pinchy/PrototypeFanControlPCB/SEM002.2003 - FanControl.brd

## EAGLE design SEM002.2003 - FanControl.brd (2020-03-23)

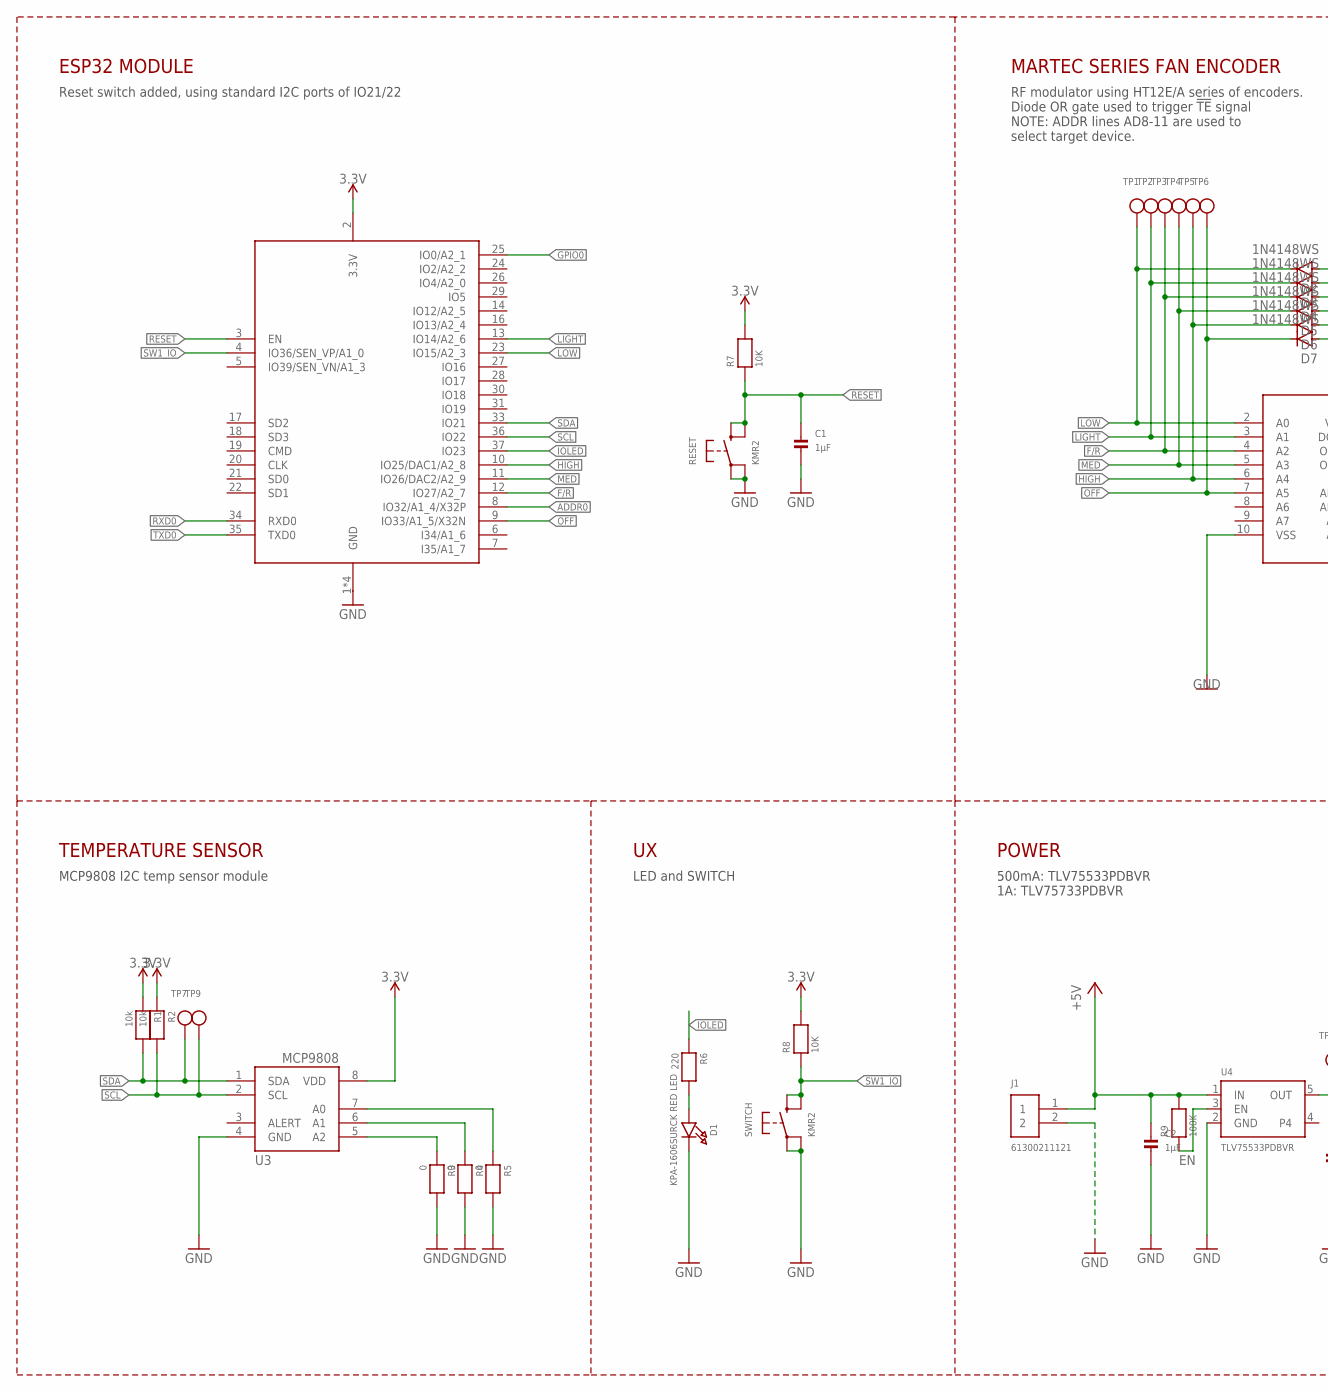
[picture p1: schematic SEM002.2003 - FanControl.sch, part in row 1, column 1]

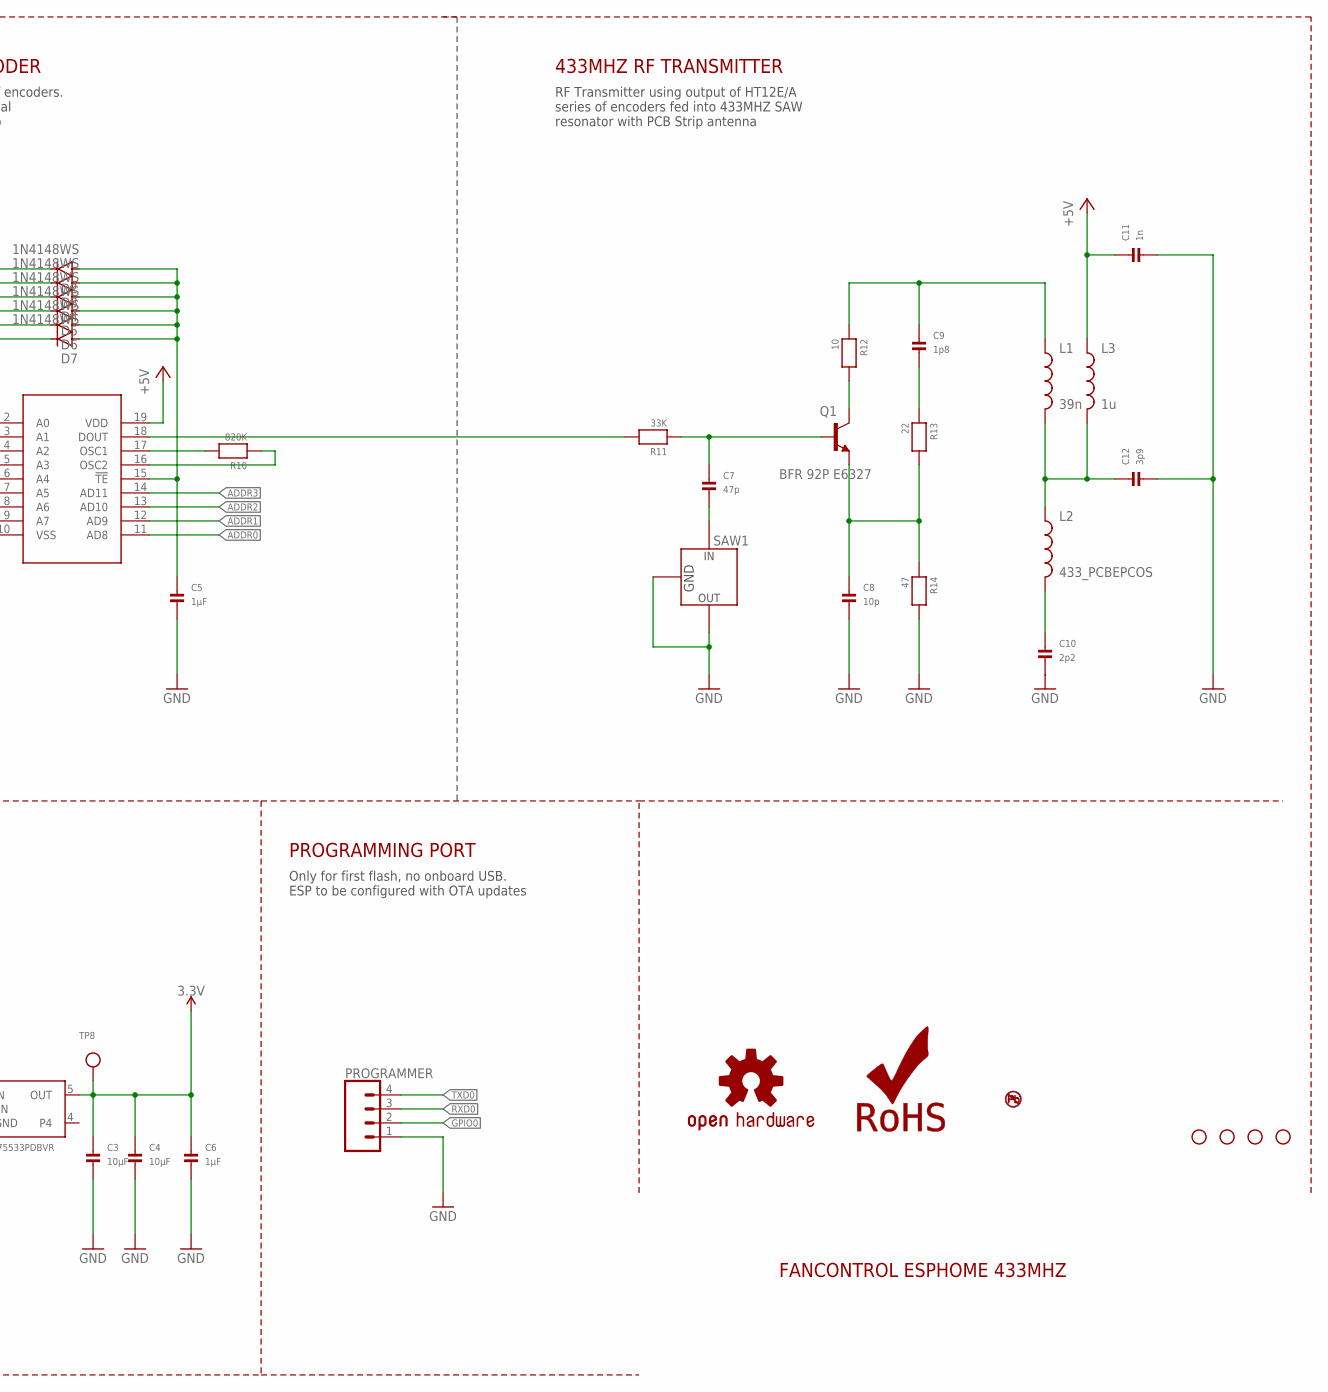
[picture p2: schematic SEM002.2003 - FanControl.sch, part in row 1, column 2]

Parts:
C1, C6: 1µF; 0603; MPN LMK107B7105KA-T
C2: 1µF; 0805_NOTHERMALS; MPN LMK107B7105KA-T
C3: 10µF; 0603; MPN 0805YD106MAT4A
C4: 10µF; 0805_NOTHERMALS; MPN 0805YD106MAT4A
C5: 1µF; 0603-MINI; MPN LMK107B7105KA-T
C7: 47p; 0603-MINI; MPN 0603N470F500CT
C8: 10p; 0603-MINI; MPN 0603N100F500CT
C9: 1p8; 0603-MINI; MPN 0603N1R8B101CT
C10: 2p2; 0603-MINI; MPN 0603N2R2B101CT
C11: 1n; 0603-MINI; MPN 0603N102F500CT
C12: 3p9; 0603-MINI; MPN 0603N3R9B101CT
D1: KPA-1606SURCK RED LED; CHIPLED_0603; MPN SML-H12U8TT86C
D2, D3, D4, D5, D6, D7: 1N4148WS; SOD-323
H1, H2, H3, H4: STAND-OFF
J1: 61300211121
L1: 39n; L0603; MPN CI160808-39NJ
L2: 433_PCBEPCOS; 433MHZ-SAW
L3: 1u; L0603; MPN AIML-0603-1R0K-T
LOGO1: OSHW-LOGOM; OSHW-LOGO-M
LOGO2: ROHS_LOGO; ROHS_LOGO_0.18_IN
LOGO3: NO_PB_LOGO; NO_PB_LOGO_0.120
PROGRAMMER: CONN_04; 1X04
Q1: BFR 92P E6327; SOT23; MPN BFR92PE6327
R1, R2: 10k; 0603; MPN APC0603B10K0N
R3, R4, R5: 0; 0603; MPN CRCW06030000Z0EAC
R6: 220; 0603; MPN CRCW0603220RFKEAC
R7, R8: 10K; 0603; MPN APC0603B10K0N
R9: 100K; 0603-MINI; MPN CRCW0603100KFKEAC
R10: 820K; 0603; MPN ERJ-3EKF8203V
R11: 33K; 0603-MINI; MPN CRCW06033K30FKEAC
R12: 10; 0603-MINI; MPN RR0816Q-100-D
R13: 22; 0603-MINI; MPN RR0816Q-220-D
R14: 47; 0603-MINI; MPN ERA-3AED470V
RESET: KMR2; BTN_KMR2_4.6X2.8; MPN KMR221GLFS
SAW1: R727QCC8C; QCC8C; MPN B39431B3730H110
SWITCH: KMR2; BTN_KMR2_4.6X2.8; MPN KMR221GLFS
TP1, TP2, TP3, TP4, TP5, TP6, TP7, TP9: TESTPOINTROUND1MM; TESTPOINT_ROUND_1MM; MPN DNL
TP8: TESTPOINTROUND1MM; TESTPOINT_ROUND_1MM
U1: ESP32_WROOM32_SKINNY; WROOM32_SKINNY; MPN ESP32-WROOM-32
U2: HT12ESO20; SO20_SOT163-1-R; MPN HT12E-20SOP
U3: MCP9808-E/MS; MSOP8_0.65MM; MPN MCP9808-E/MS
U4: TLV75533PDBVR; SOT23-5; MPN TLV75733PDBVR

Connections:
3.3V: C3.1, C4.1, C6.1, R1.1, R2.1, R7.2, R8.2, TP8.P$1, U1.2 (3.3V), U3.8 (VDD), U4.5 (OUT)
+5V: C2.1, C11.1, J1.1, L3.1, R9.2, U2.19 (VDD), U4.1 (IN)
ADDR0: U1.8 (IO32/A1_4/X32P), U2.11 (AD8)
ADDR1: U2.12 (AD9)
ADDR2: U2.13 (AD10)
ADDR3: U2.14 (AD11)
EN: R9.1, U4.3 (EN)
F/R: D4.C, TP3.P$1, U1.12 (IO27/A2_7), U2.4 (A2)
GND: C1.2, C2.2, C3.2, C4.2, C5.2, C6.2, C8.2, C10.2, C11.2, C12.2, D1.C, J1.2, PROGRAMMER.1, R3.2, R4.2, R5.2, R14.2, RESET.A, RESET.A' (P1), SAW1.P$1, SAW1.P$3, SAW1.P$4, SAW1.P$5, SAW1.P$6, SWITCH.A, SWITCH.A' (P1), U1.1 (GND), U1.15 (GND), U1.38 (GND), U1.P$1 (GND), U2.10 (VSS), U3.4 (GND), U4.2 (GND)
GPIO0: PROGRAMMER.2, U1.25 (IO0/A2_1)
HIGH: D6.C, TP5.P$1, U1.10 (IO25/DAC1/A2_8), U2.6 (A4)
IOLED: R6.1, U1.37 (IO23)
LIGHT: D3.C, TP2.P$1, U1.13 (IO14/A2_6), U2.3 (A1)
LOW: D2.C, TP1.P$1, U1.23 (IO15/A2_3), U2.2 (A0)
MED: D5.C, TP4.P$1, U1.11 (IO26/DAC2/A2_9), U2.5 (A3)
unnamed: R5.1, U3.7 (A0)
unnamed: C5.1, D2.A, D3.A, D4.A, D5.A, D6.A, D7.A, U2.15 (!TE!)
unnamed: R4.1, U3.6 (A1)
unnamed: R10.2, U2.17 (OSC1)
unnamed: D1.A, R6.2
unnamed: R10.1, U2.16 (OSC2)
unnamed: R3.1, U3.5 (A2)
unnamed: R11.2, U2.18 (DOUT)
unnamed: C7.1, Q1.1 (B), R11.1
unnamed: Q1.3 (C), R12.2
unnamed: C9.2, R13.1
unnamed: C8.1, Q1.2 (E), R13.2, R14.1
unnamed: C7.2, SAW1.P$2
unnamed: C9.1, L1.1, R12.1
unnamed: C12.1, L1.2, L2.P$1 (1), L3.2
unnamed: C10.1, L2.P$2 (2)
OFF: D7.C, TP6.P$1, U1.9 (IO33/A1_5/X32N), U2.7 (A5)
RESET: C1.1, R7.1, RESET.B (S), RESET.B' (S1), U1.3 (EN)
RXD0: PROGRAMMER.3, U1.34 (RXD0)
SCL: R2.2, TP9.P$1, U1.36 (IO22), U3.2 (SCL)
SDA: R1.2, TP7.P$1, U1.33 (IO21), U3.1 (SDA)
SW1_IO: R8.1, SWITCH.B (S), SWITCH.B' (S1), U1.4 (IO36/SEN_VP/A1_0)
TXD0: PROGRAMMER.4, U1.35 (TXD0)

Notes on the sheet:
500mA: TLV75533PDBVR 1A: TLV75733PDBVR
MARTEC SERIES FAN ENCODER
RF modulator using HT12E/A series of encoders. Diode OR gate used to trigger !TE! signal NOTE: ADDR lines AD8-11 are used to select target device.
433MHZ RF TRANSMITTER
RF Transmitter using output of HT12E/A series of encoders fed into 433MHZ SAW resonator with PCB Strip antenna
TEMPERATURE SENSOR
MCP9808 I2C temp sensor module
POWER
ESP32 MODULE
Reset switch added, using standard I2C ports of IO21/22
Only for first flash, no onboard USB. ESP to be configured with OTA updates
PROGRAMMING PORT
LED and SWITCH

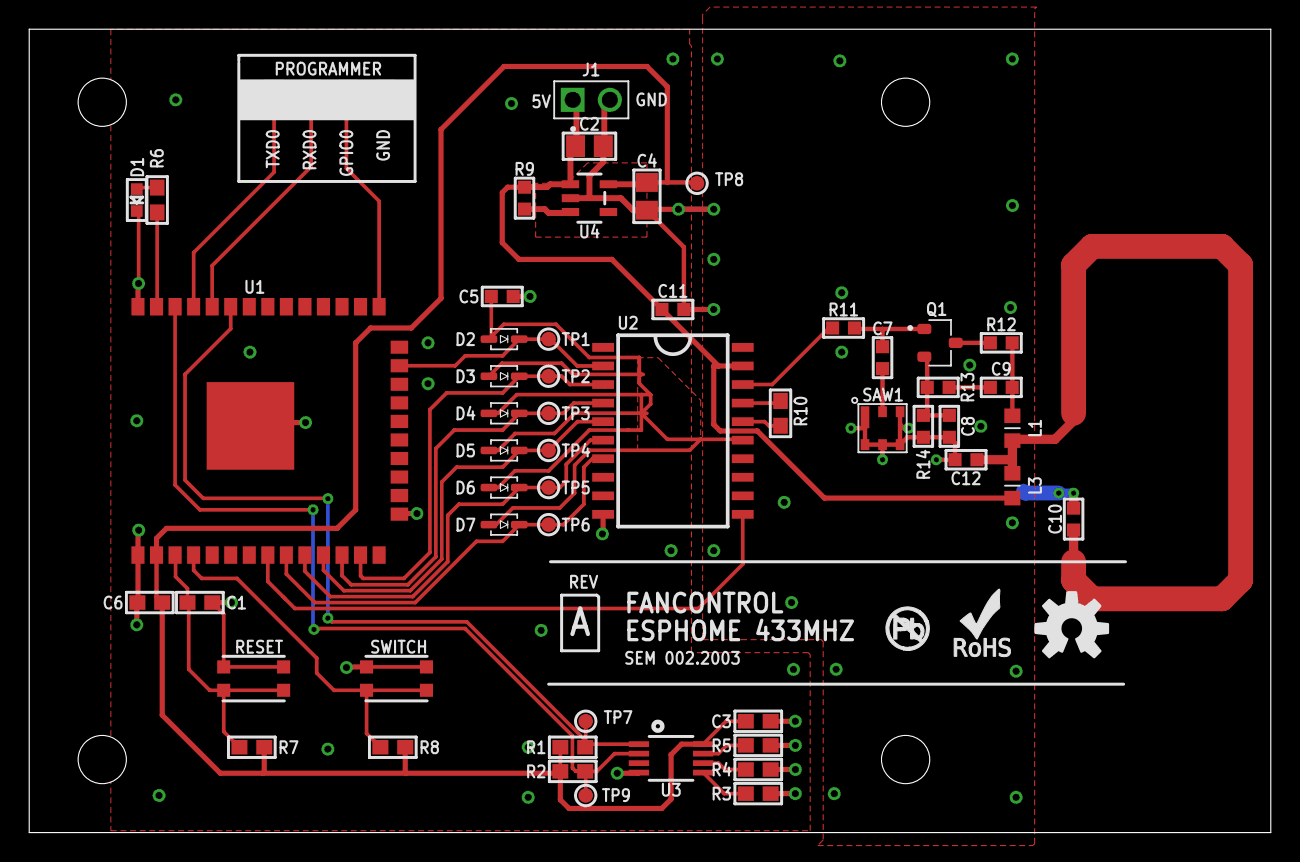
[picture p3: board SEM002.2003 - FanControl.brd from above]

Board: 2 copper layers, 85.0 x 55.0 mm, 62 parts (0 on the bottom side), 35 nets.
